kvsriram11/Hardware-for-AI-ML/codefest/cf03/cman_dram_traffic.pdf

ECE510: Hardware for AI & ML
Venkata Sriram Kamarajugadda | Codefest 3 — CMAN Task

# ECE510: Hardware for Artificial Intelligence & Machine Learning

Codefest 3 — CMAN Task | — Spring 2026
Instructor: Prof. Christof Teuscher | — Student: Venkata Sriram Kamarajugadda

### DRAM Traffic Analysis: Naive vs. Tiled Matrix Multiply

Consider multiplying two square FP32 matrices of size N ×N where N = 32. Matrix elements are stored and accessed in row-major order.

Given constants:

Parameter | Symbol Value
Matrix dimension | N | 32
Tile size | T | 8
Precision | — | FP32 (4 bytes/element)
DRAM bandwidth BW | 320 GB/s
Peak compute | P | 10 TFLOP/s

### Task 1. Naive Triple Loop — DRAM Traffic

Question. For the naive ijk loop order, computing one output element

C[i][j] =

N

X⁻¹

k=0

A[i][k] × B[k][j],

how many times is each element of B accessed? Across the full N × N output, how many total element accesses are made to A and B? Compute total DRAM traffic in bytes assuming every element access goes to DRAM (no data reuse).

Solution.

Accesses per output element. To compute a single C[i][j], the processor reads:

- one full row of A: A[i][0], A[i][1], . . . , A[i][N−1] — N = 32 reads,
- one full column of B: B[0][j], B[1][j], . . . , B[N−1][j] — N = 32 reads.

Total accesses over all N² output elements.

Accesses to A = N

2
- N = N

3 = 32³ = 32,768

Accesses to B = N

2
- N = N

3 = 32³ = 32,768

Total element accesses = 2N

3 = 65,536

DRAM traffic (4 bytes per FP32 element, no reuse).

Trafficnaive = 2N

3 × 4 bytes = 65,536 × 4

Naive DRAM traffic = 262,144 bytes = 256 KB

### Task 2. Tiled Loop — DRAM Traffic

Question. The computation is blocked into T × T tiles where T = 8. Compute the number of DRAM loads for A and B tiles across the full computation. Compute total DRAM traffic in bytes.

Solution.

In the ideal tiled model, tiling allows data loaded from DRAM to be fully reused on-chip within the tile. Rather than re-fetching a tile for every output tile that needs it, each unique tile is brought from DRAM exactly once. We therefore count the unique matrix data that must be transferred from DRAM.

Each matrix has N² = 32² = 1,024 elements.

Total DRAM loads for A. Each element of A is loaded once from DRAM:

N

2 = 1,024 elements

Total DRAM loads for B. Each element of B is loaded once from DRAM:

N

2 = 1,024 elements

Total element loads.
1,024 + 1,024 = 2,048 elements

DRAM traffic (4 bytes per FP32 element).

Traffictiled = 2,048 × 4 bytes

Tiled DRAM traffic = 8,192 bytes = 8 KB

### Task 3. Traffic Ratio

Question. Compute the ratio of naive DRAM traffic to tiled DRAM traffic. Explain in one sentence why this ratio equals N.

Solution.
Trafficnaive
Traffictiled

=

2N³ × 4
2N² × 4

= N = 32

Naive/Tiled traffic ratio = 32

One-sentence explanation. The ratio equals N because the naive GEMM reads matrix data from DRAM O(N³
) times (each element reread for every output row or column), while ideal tiled GEMM loads each matrix element exactly once from DRAM and reuses it entirely on-chip, reducing traffic from O(N³

) to O(N²
).

### Task 4. Execution Time and Bottleneck Classification

Question. If DRAM bandwidth is 320 GB/s and peak compute is 10 TFLOP/s, compute execution time for the naive case and the tiled case. For each, state whether the bottleneck is compute or memory.

Solution.

Common arithmetic workload. Both cases perform the same floating-point work:

W = 2N

3 = 2 × 32³ = 65,536 FLOPs

tcompute =

W
P

=

65,536
10 × 10¹²

≈ 6.6 ns

Naive case.
t

naive
mem =

262,144 bytes
320 × 10⁹ bytes/s = 819.2 ns

tcompute = 6.6 ns ≪ t

naive
mem = 819.2 ns tnaive ≈ 819.2 ns Bottleneck: memory-bound

Tiled case.
t

tiled
mem =

8,192 bytes
320 × 10⁹ bytes/s = 25.6 ns

tcompute = 6.6 ns < ttiled
mem = 25.6 ns

ttiled ≈ 25.6 ns Bottleneck: memory-bound

Both cases remain memory-bound for N = 32. Tiling reduces execution time by a factor of N = 32 by cutting DRAM traffic from O(N³

) to O(N²
). The tiled case is much closer to the compute limit (25.6 ns vs. 6.6 ns), but the arithmetic intensity is still below the hardware ridge point.

### Summary

| DRAM Traffic | Execution Time | Bottleneck
Naive 256 KB (262,144 bytes) | ≈ 819.2 ns | Memory-bound
Tiled | 8 KB (8,192 bytes) | ≈ 25.6 ns | Memory-bound
Ratio | | N = 32
