kvsriram11/Hardware-for-AI-ML/codefest/cf02/profiling/roofline_project.png

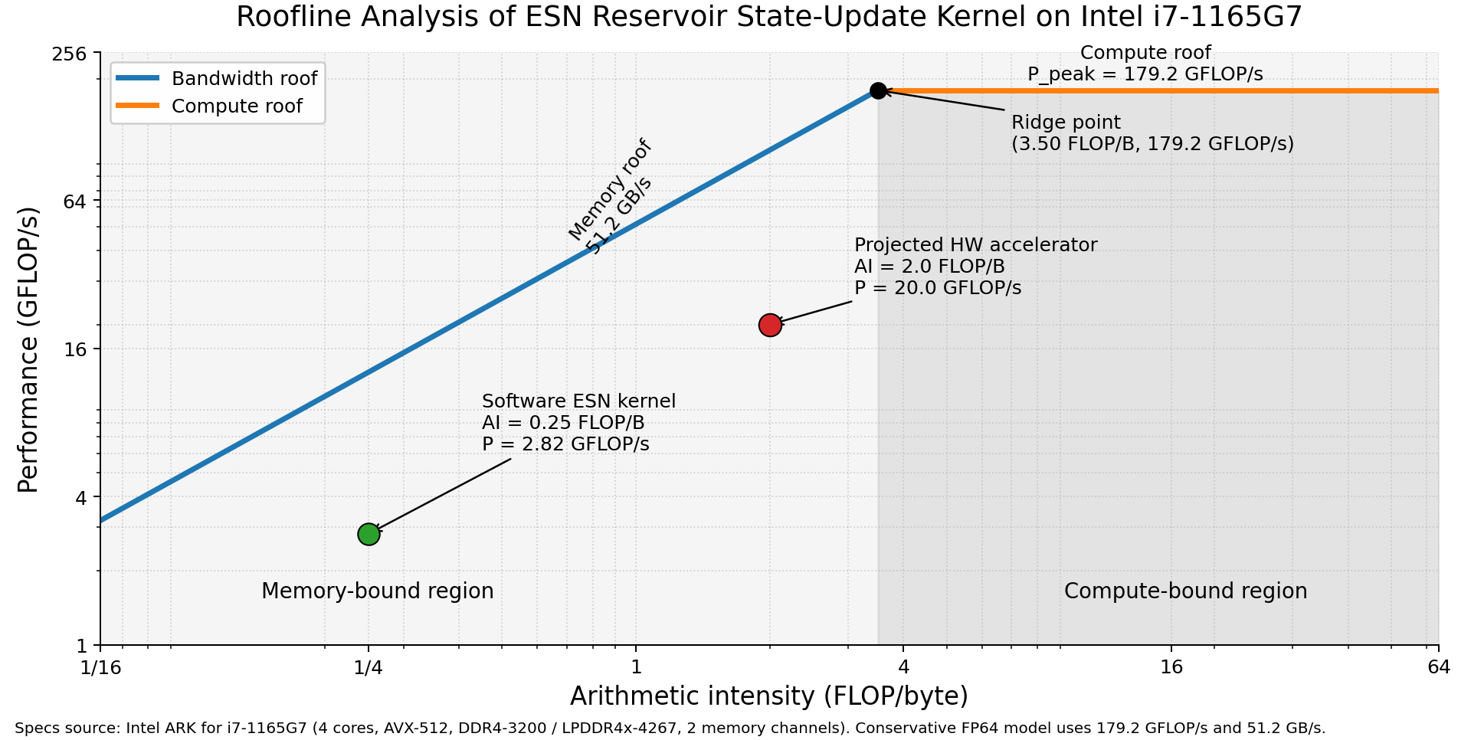
codefest/cf02/profiling/roofline_project.png
