kvsriram11/Hardware-for-AI-ML/codefest/cf03/profiling/gemm_roofline.png

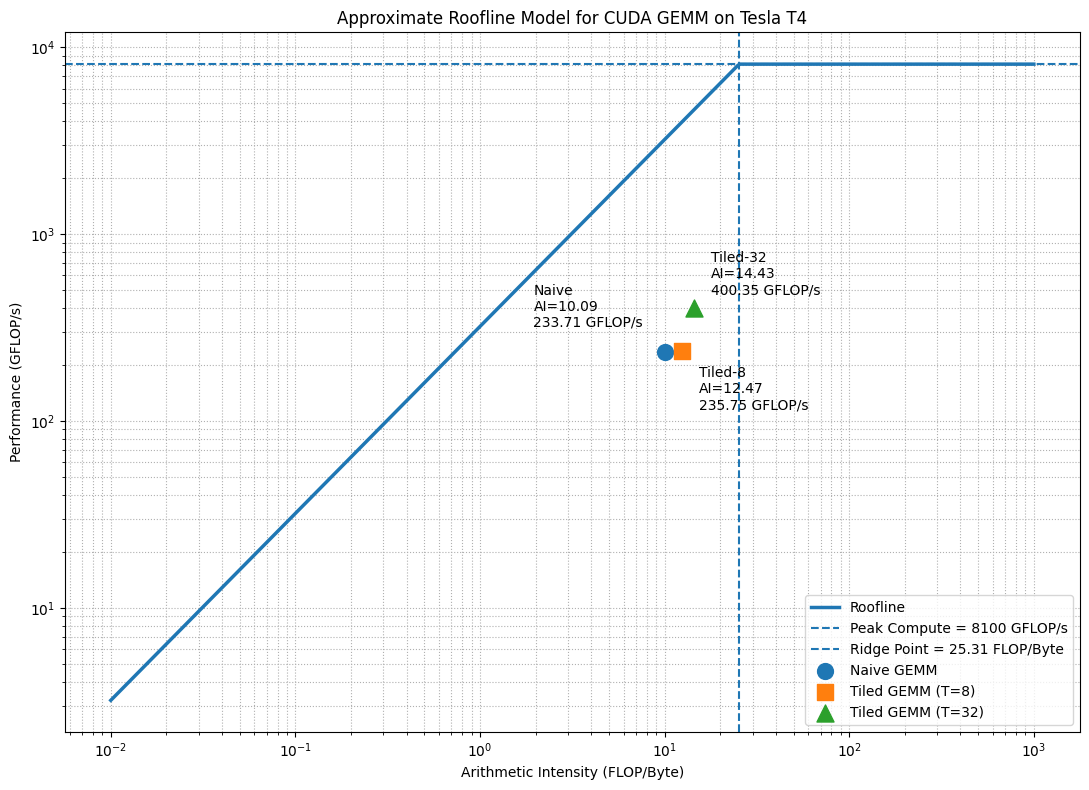
codefest/cf03/profiling/gemm_roofline.png
