kvsriram11/Hardware-for-AI-ML/codefest/cf04/cocotb_mac/waveform.png

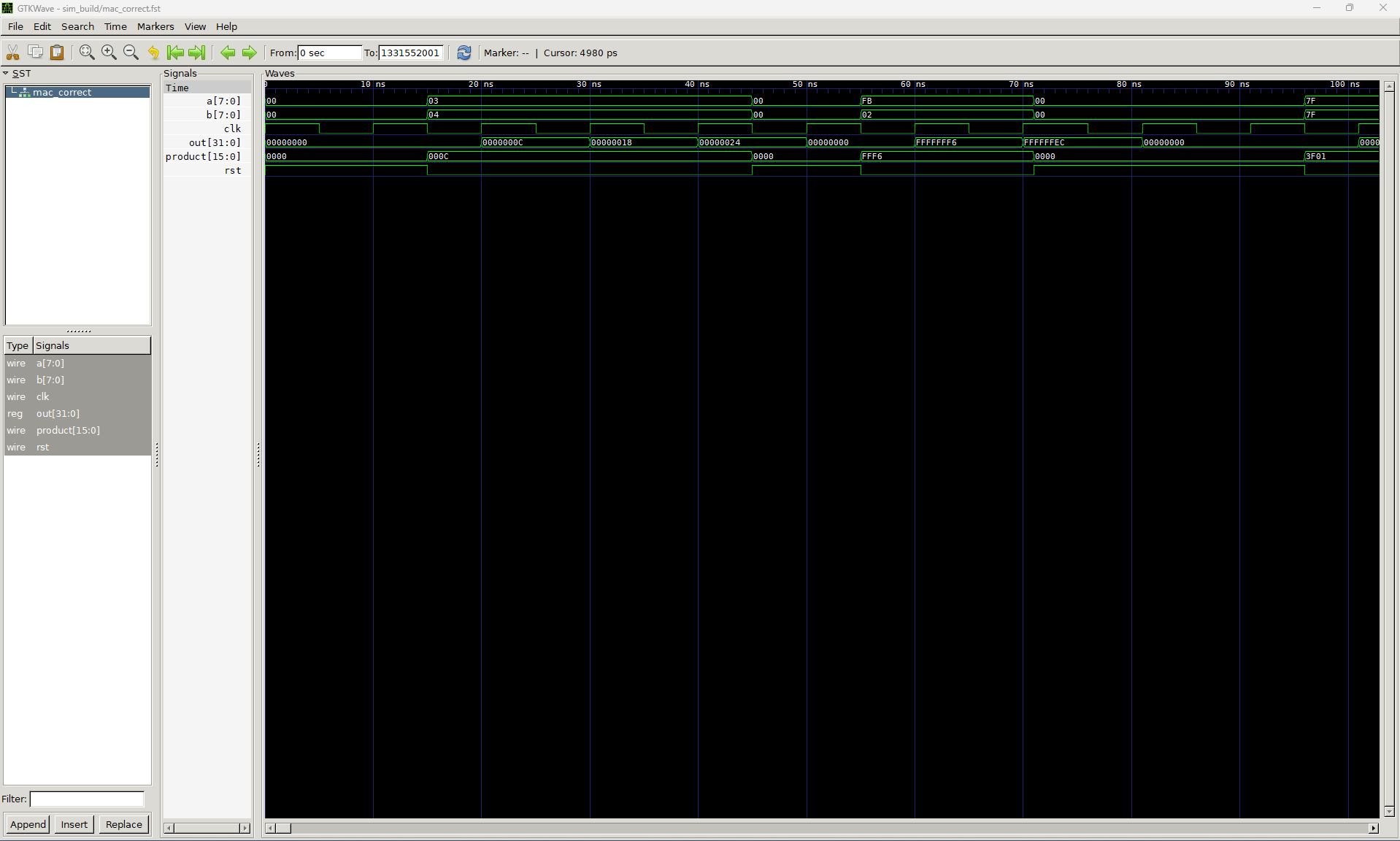
codefest/cf04/cocotb_mac/waveform.png
