kvsriram11/Hardware-for-AI-ML/codefest/cf04/hdl/Transcript.png

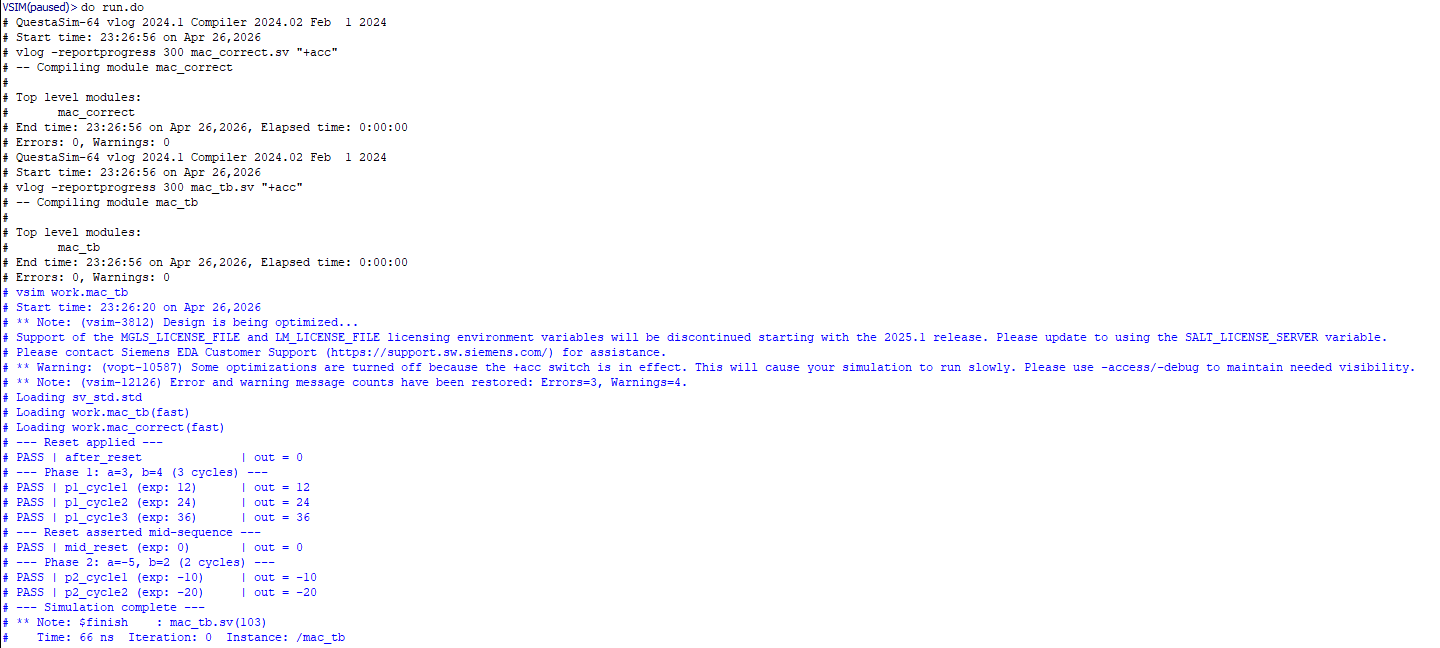
codefest/cf04/hdl/Transcript.png
