kvsriram11/Hardware-for-AI-ML/codefest/cf04/hdl/Waveform.png

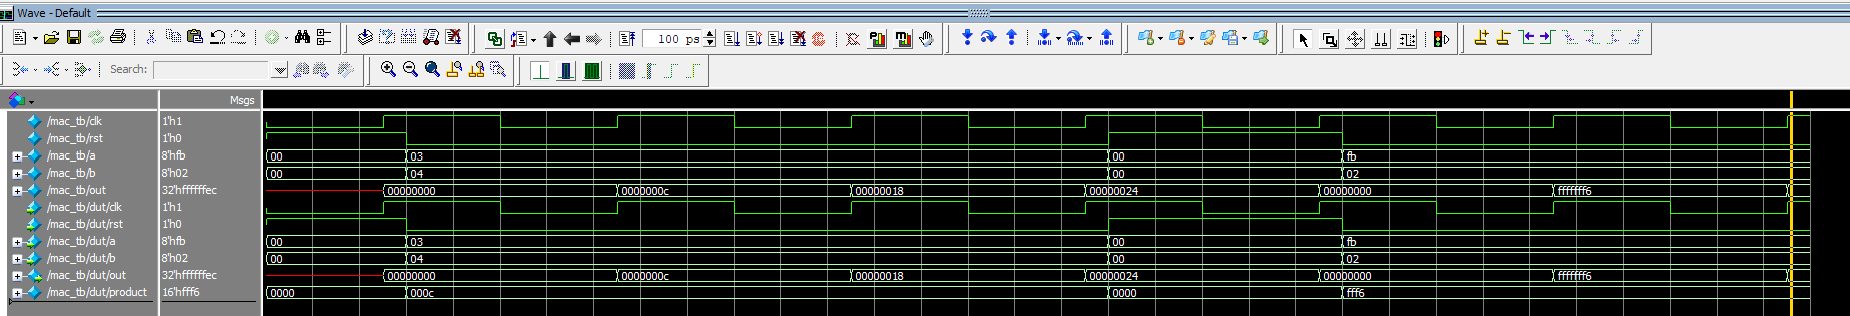
codefest/cf04/hdl/Waveform.png
