kvsriram11/Hardware-for-AI-ML/project/m1/profiling/analysis/roofline_project.png

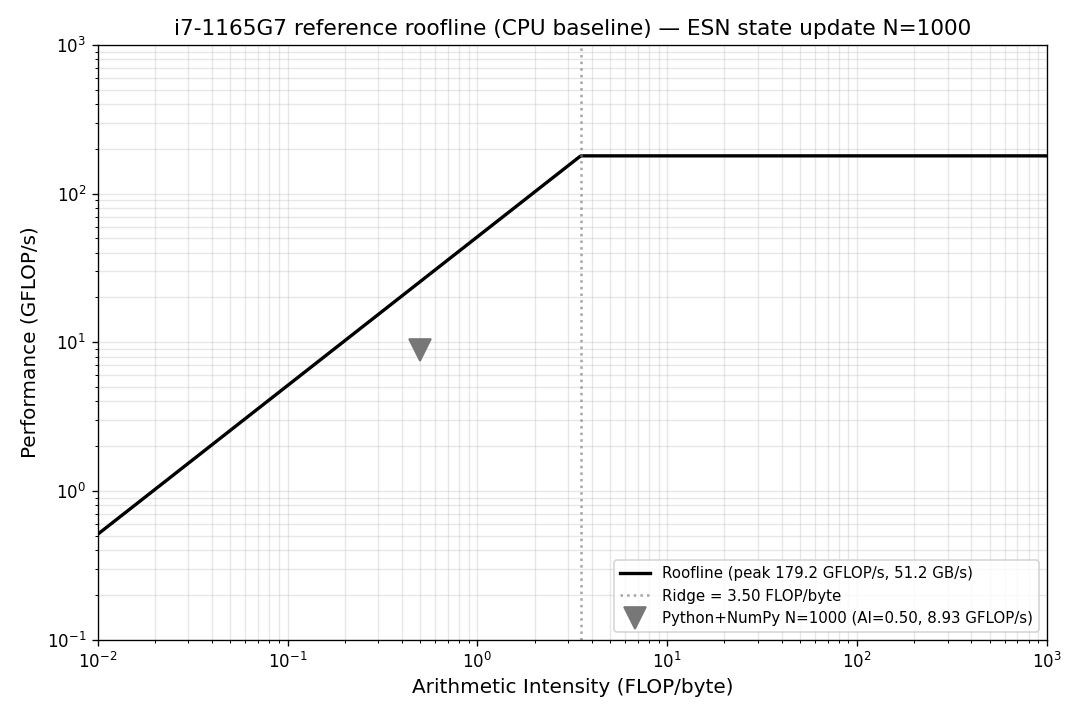
project/m1/profiling/analysis/roofline_project.png
