kvsriram11/Hardware-for-AI-ML/project/m1/system_diagram.png

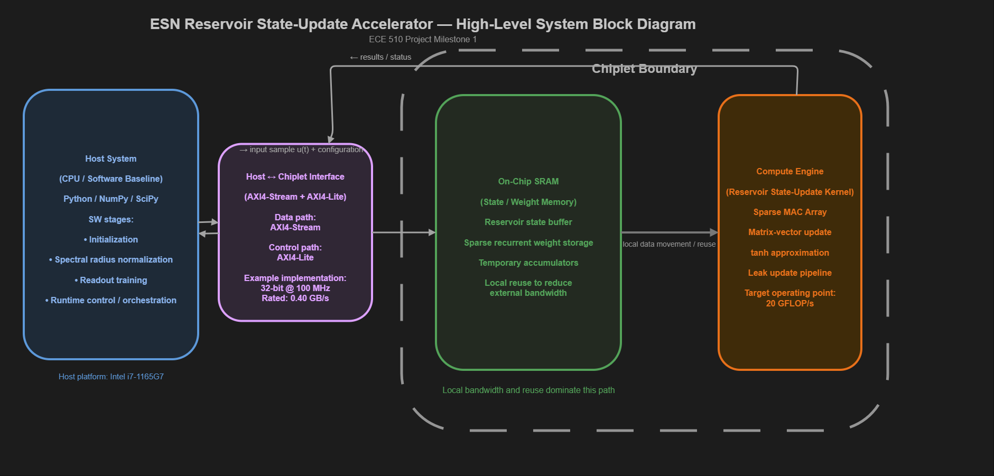
project/m1/system_diagram.png
