kvsriram11/Hardware-for-AI-ML/project/m2/sim/waveform.png

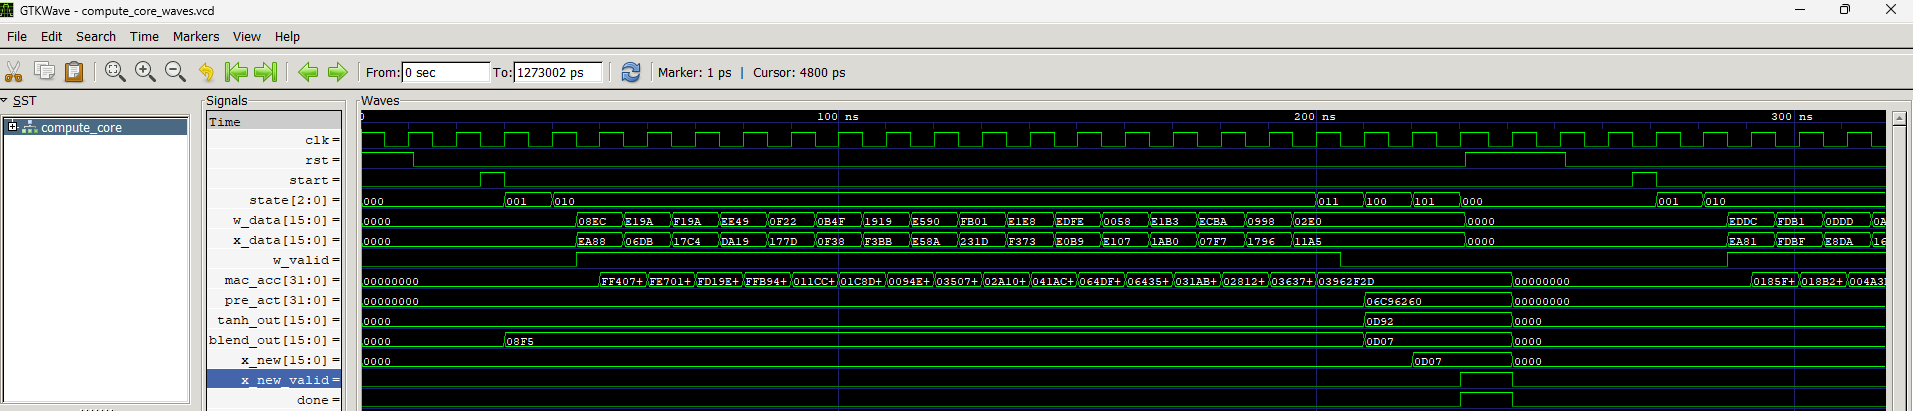
project/m2/sim/waveform.png
