kvsriram11/Hardware-for-AI-ML/project/m3/sim/cosim_waveform.png

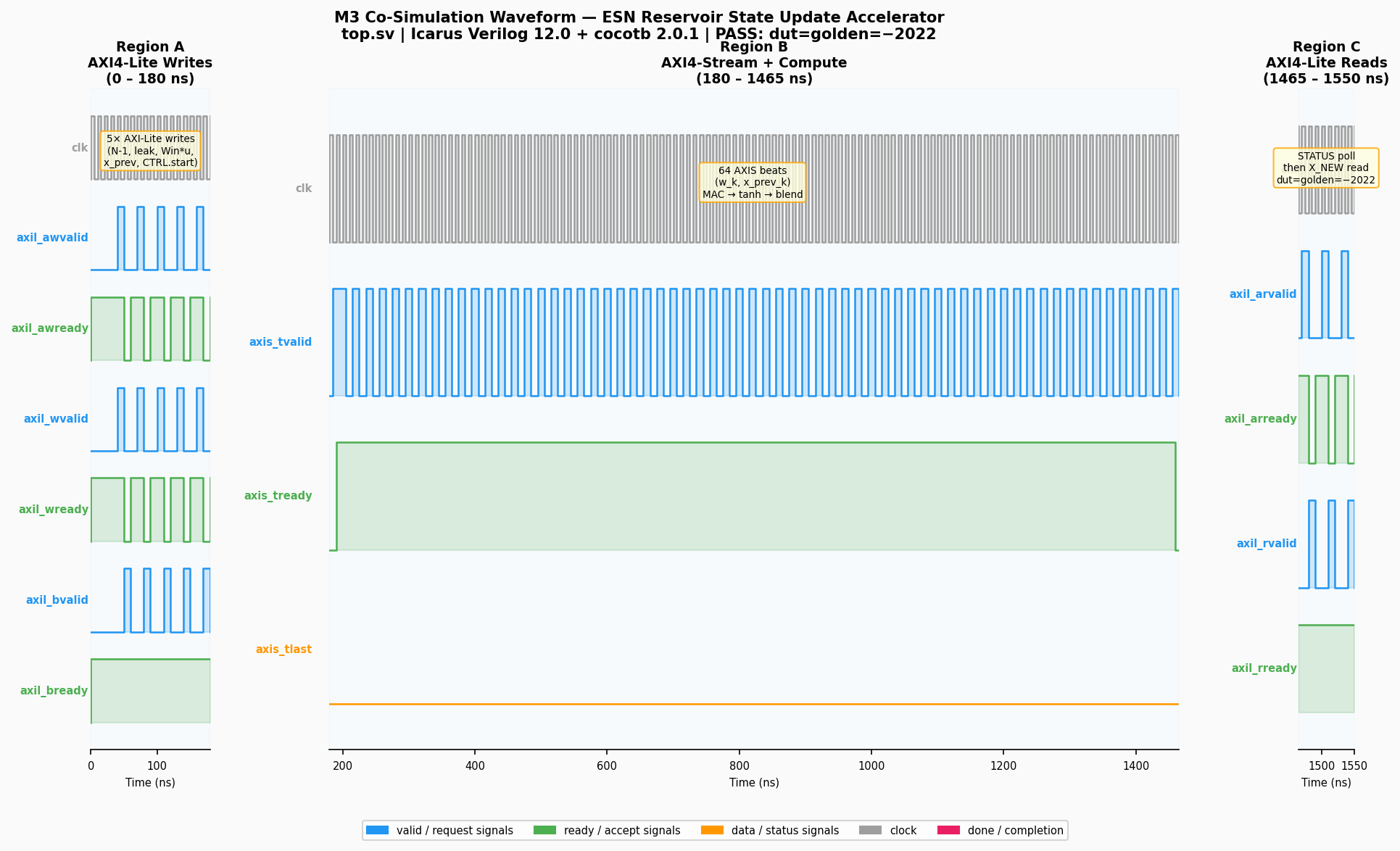
project/m3/sim/cosim_waveform.png
