kvsriram11/Hardware-for-AI-ML/project/m4/report/figures/waveform.png

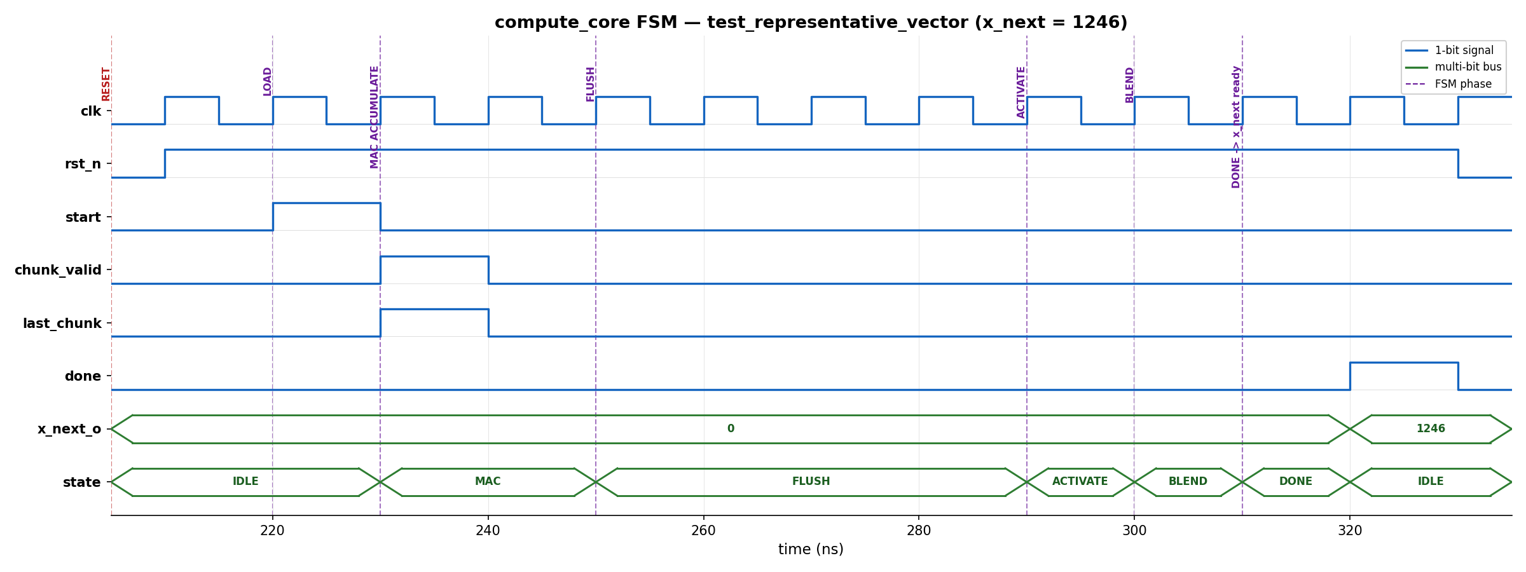
project/m4/report/figures/waveform.png
