kvsriram11/Hardware-for-AI-ML/project/m4/sim/final_waveform.png

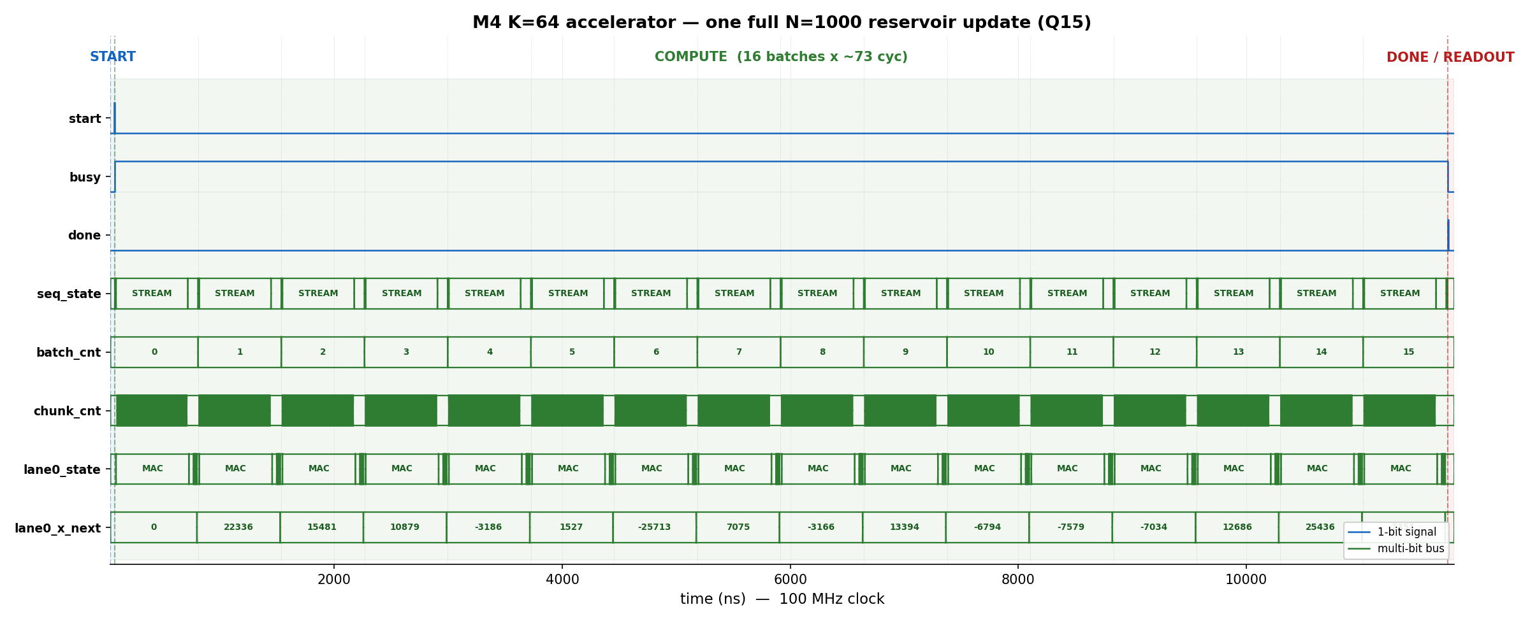
project/m4/sim/final_waveform.png
