kvsriram11/Hardware-for-AI-ML/(commit log)

2026-04-06 Add draft for hardware accelerator design in reservoir computing
    Draft document outlining the design of a hardware accelerator for reservoir computing, focusing on spoken digit classification and the limitations of current software implementations.
2026-04-20 Add nn_forward_gpu.py for GPU-based neural network
    This script initializes a neural network model and checks CUDA availability. It also prints input and output tensor shapes along with their device status.
2026-05-04 M2: ESN compute core + AXI interface, all tests passing
    RTL (synthesizable, parameterized DATA_W=16 / ACC_W=32):
    - q15_mac: serial multiply-accumulate, Q15 operands, Q30 accumulator
    - q15_tanh: 7-segment piecewise-linear tanh approximation
    - q15_blend: leak-rate state update (1-a)*x_prev + a*tanh
    - compute_core: 5-state FSM running one neuron's full ESN update
    - interface: AXI4-Lite (config+status) + AXI4-Stream (operands)
    Verification (cocotb 2.0.1 + Icarus 12.0, all PASS vs NumPy golden):
    - q15_mac 4/4 PASS
    - q15_tanh 3/3 PASS (PWL max abs err 0.073 vs math.tanh)
    - q15_blend 4/4 PASS
    - compute_core 3/3 PASS (M2-graded, single-neuron, N=16/64)
    - interface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
    [compute_core.sv, interface.sv, test_compute_core.py, test_interface.py]
2026-05-04 Add systolic array trace documentation
    Document the systolic array trace for matrix multiplication with detailed cycle-by-cycle analysis and counts.
2026-05-04 Revise CMAN systolic trace documentation
    Updated the document to reflect changes in deliverables and formatting.
2026-05-11 Add documentation for CMAN sneak paths in crossbar
    Documented the behavior of sneak paths in a 2x2 resistive crossbar, including ideal read conditions, floating node voltages, actual current measurements, and implications for matrix-vector multiplication.
2026-05-17 CF07: CMAN sparsity analysis + Option B OpenLane synthesis (crossbar_mac) + scope assessment
    [metrics.csv]
2026-05-25 Add AER off-chip interface analysis for CMAN
    Added detailed analysis of the AER off-chip interface for a 1024-neuron SNN accelerator, including system parameters, bandwidth calculations, interface comparisons, burst analysis, and frame-based comparisons.
2026-06-08 M4 submission: restructure project/ to milestone checklist (M1-M4)
    Populate project/{m1,m2,m3,m4} to the exact graded path layout from the
    ESN-redo workspace: RTL, cocotb testbenches, sim logs/waveforms, sky130
    synthesis (Yosys), benchmarks, roofline, and the design-justification PDF.
    Add cocotb->SV and Yosys->OpenLane shim files documenting tool deviations.
    codefest/ left untouched.
    M4 headline: K=64 parallel-lane accelerator, 1169 cycles/N=1000 update,
    10.27x vs C+OpenBLAS at Q15 (125 MHz); Q15/INT8/Q4 precision sweep.
    [benchmark_data.csv, sweep_data.csv]
